eemreeh/High-Gain-Microstrip-Antenna-Designs-for-A-Doppler-Radar/README.md

# High-Gain-Microstrip-Antenna-Designs-for-A-Doppler-Radar
